naoyuki-iot/RRC_damian_2019/Pictures/soldered_parts_PCB.jpeg

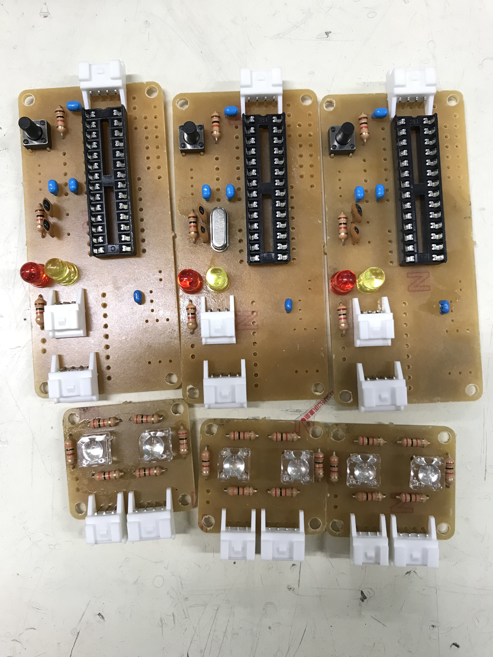
Pictures/soldered_parts_PCB.jpeg
