naoyuki-iot/RRC_damian_2019/Pictures/Head_Damian_Board.jpeg

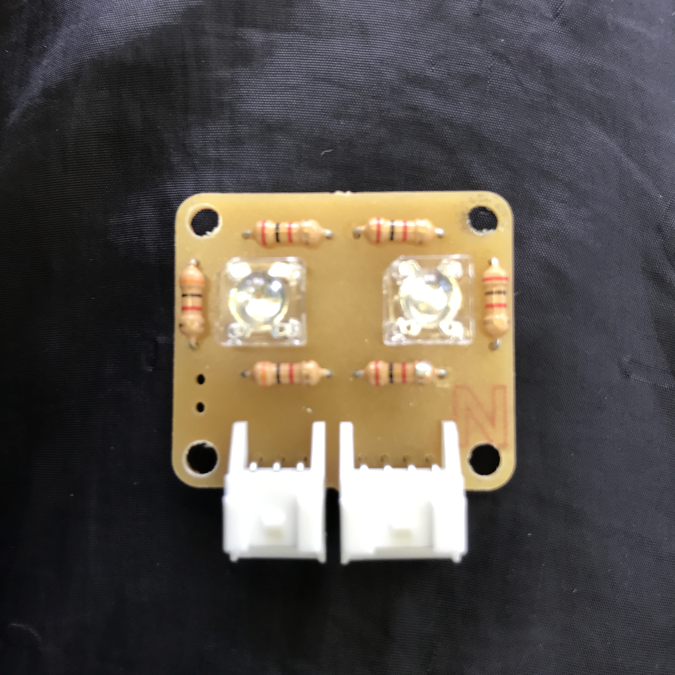
Pictures/Head_Damian_Board.jpeg
