naoyuki-iot/RRC_damian_2019/README.md

# RRC_damian_2019
- "Damian" is a rescue dummy as a rescuer on RRC.
