naoyuki-iot/RRC_damian_2019/Pictures/Body_Damian.png

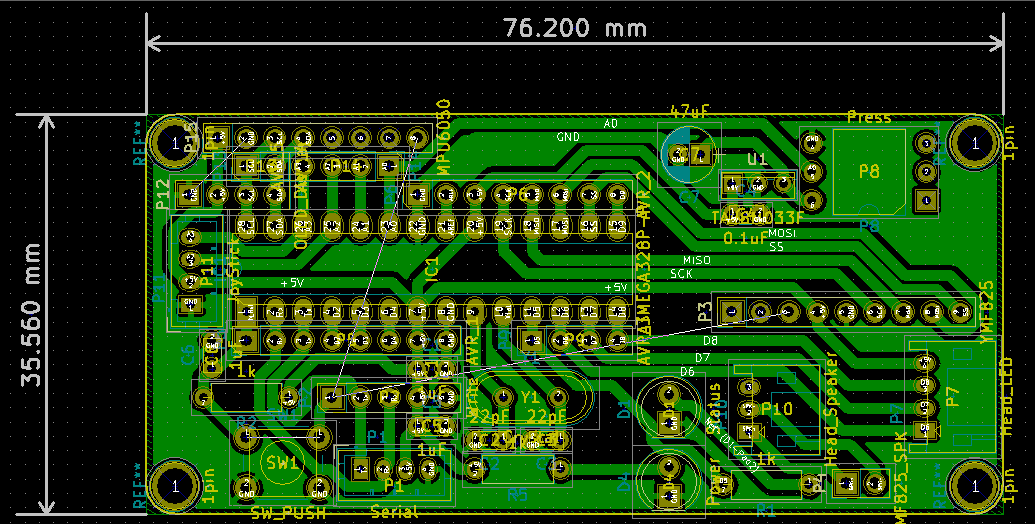
Pictures/Body_Damian.png
