naoyuki-iot/RRC_damian_2019/Pictures/Body_Damian_Board.jpeg

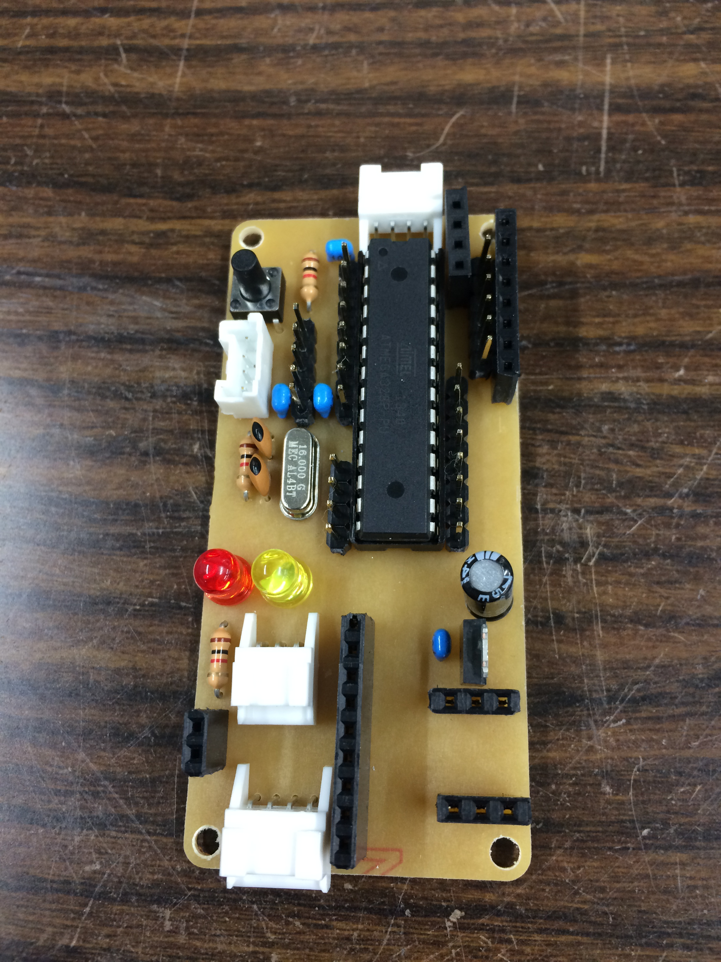
Pictures/Body_Damian_Board.jpeg
