naoyuki-iot/RRC_damian_2019/Pictures/Head_Damian.png

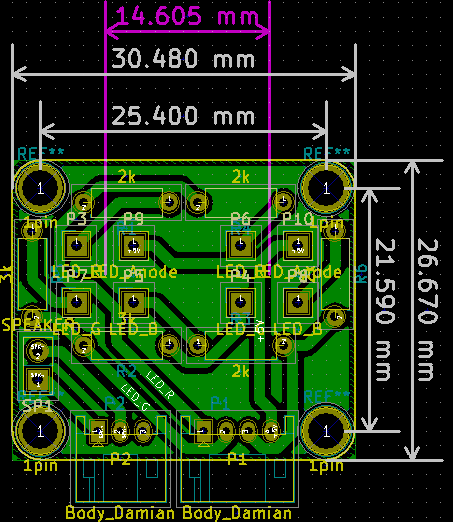
Pictures/Head_Damian.png
