naoyuki-iot/RRC_damian_2019/Pictures/raw_PCB.jpeg

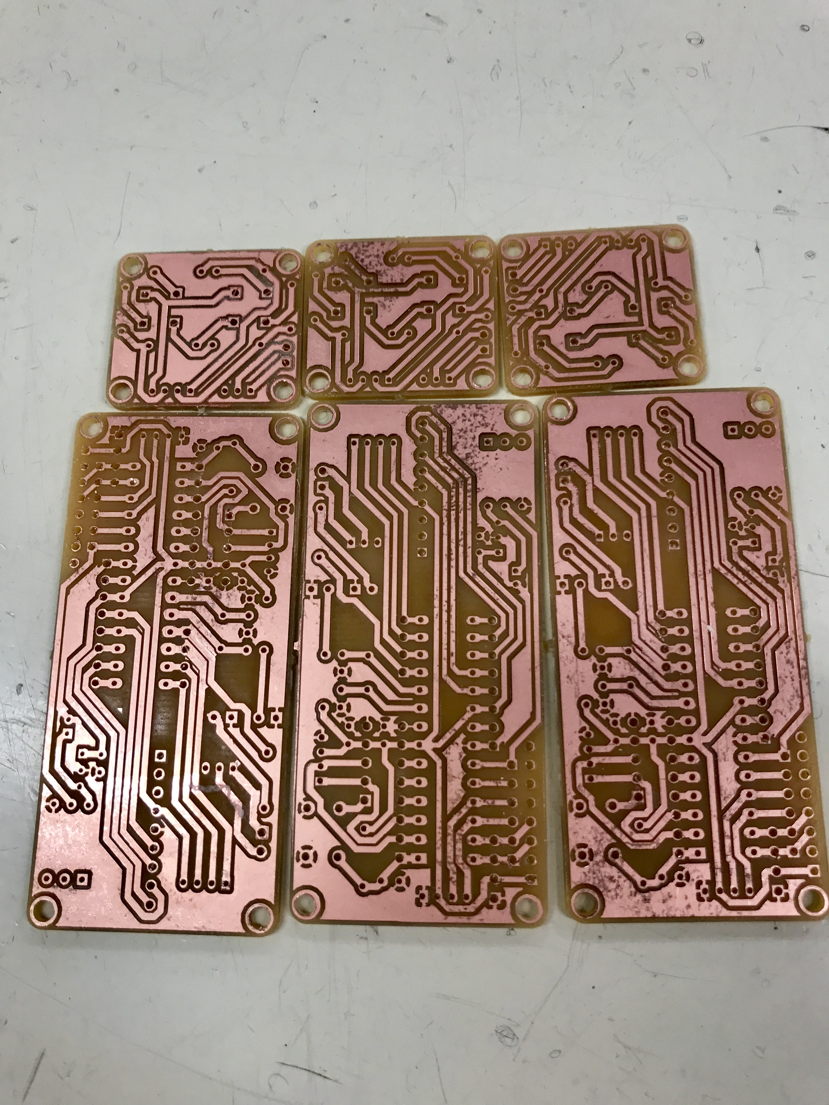
Pictures/raw_PCB.jpeg
