naoyuki-iot/RRC_damian_2019/Pictures/SerialCable(TTL232).jpg

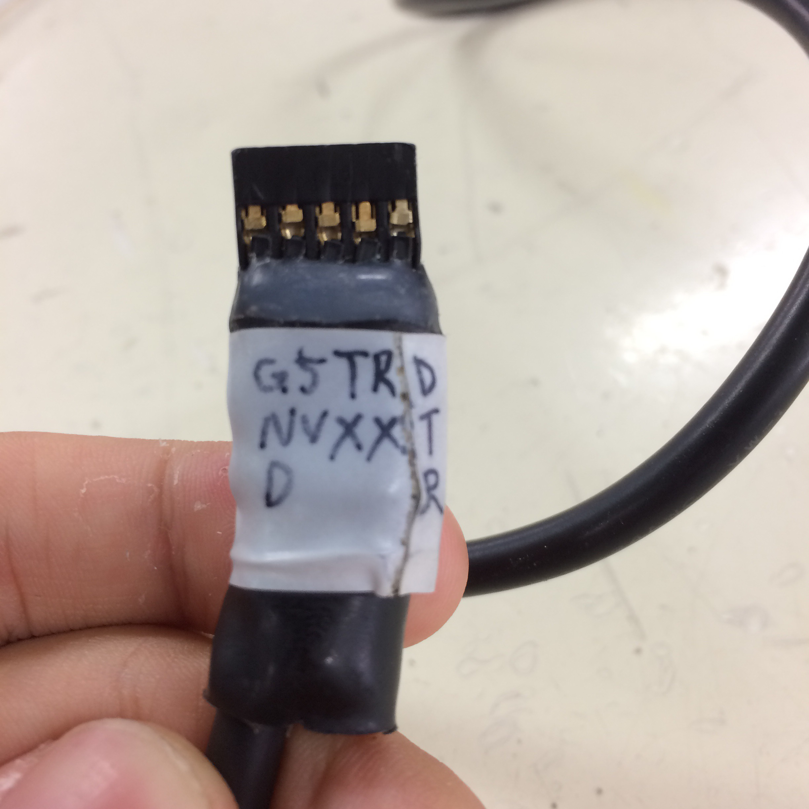
Pictures/SerialCable(TTL232).jpg
