naoyuki-iot/RRC_damian_2019/Circuits/Body_Damian_v2/Main-MPU.kicad_pcb

## KiCad design Circuits/Body_Damian_v2/Main-MPU.kicad_pcb (2020-06-12)

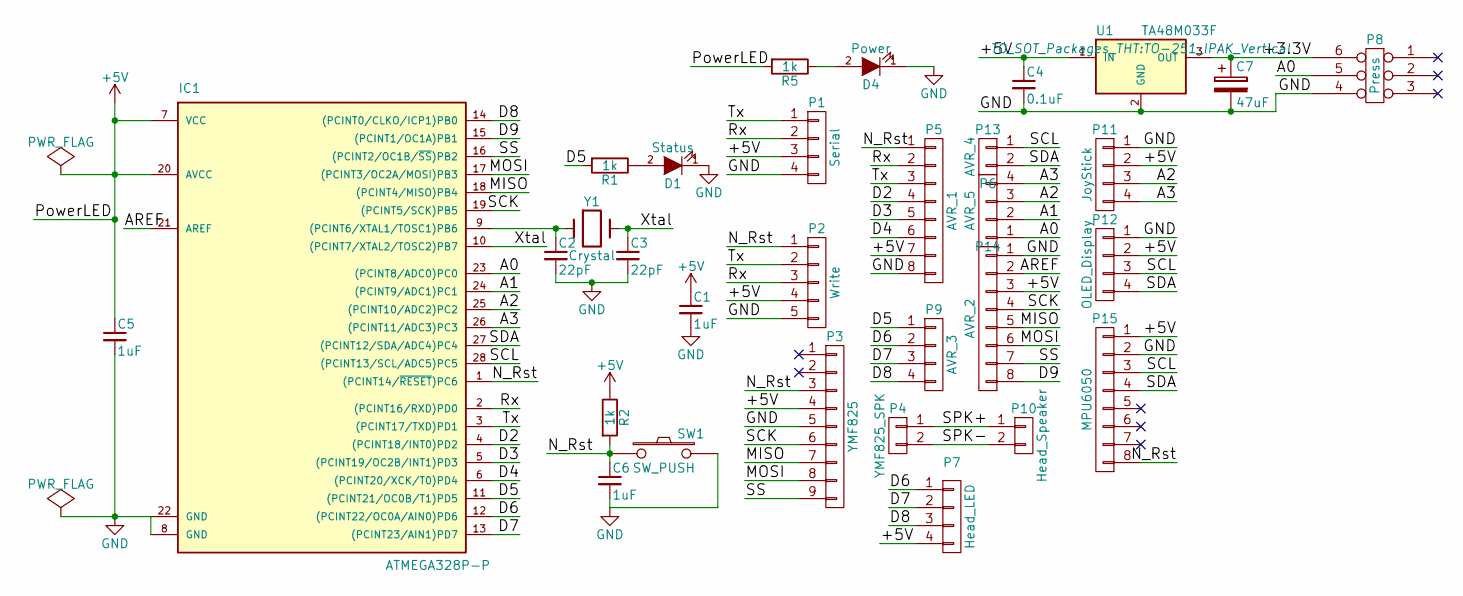
[picture p8: schematic Main-MPU.sch]

Parts:
C1, C5, C6: 1uF; C_Disc_D3.0mm_W1.6mm_P2.50mm
C2, C3: 22pF; C_Disc_D3.0mm_W1.6mm_P2.50mm
C4: 0.1uF; C_Disc_D3.0mm_W1.6mm_P2.50mm
C7: 47uF; CP_Radial_D5.0mm_P2.00mm
D1: Status; LED_D5.0mm
D4: Power; LED_D5.0mm
IC1: ATMEGA328P-P; DIP-28_W7.62mm_LongPads
P1: Serial; JST_PH_B4B-PH-K_04x2.00mm_Straight
P2: Write; Pin_Header_Straight_1x05_Pitch2.54mm
P3: YMF825; Socket_Strip_Straight_1x09_Pitch2.54mm
P4: YMF825_SPK; Socket_Strip_Straight_1x02_Pitch2.54mm
P5: AVR_1; Pin_Header_Straight_1x08_Pitch2.54mm
P6: AVR_2; Pin_Header_Straight_1x08_Pitch2.54mm
P7: Head_LED; JST_PH_S4B-PH-K_04x2.00mm_Angled
P8: Press; DIP-6_W10.16mm
P9: AVR_3; Pin_Header_Straight_1x04_Pitch2.54mm
P10: Head_Speaker; JST_PH_S3B-PH-K_03x2.00mm_Angled
P11: JoyStick; JST_PH_B4B-PH-K_04x2.00mm_Straight
P12: OLED_Display; Socket_Strip_Straight_1x04_Pitch2.54mm
P13: AVR_4; Pin_Header_Straight_1x02_Pitch2.54mm
P14: AVR_5; Pin_Header_Straight_1x04_Pitch2.54mm
P15: MPU6050; Socket_Strip_Straight_1x08_Pitch2.54mm
R1, R2, R5: 1k; R_Axial_DIN0207_L6.3mm_D2.5mm_P7.62mm_Horizontal
SW1: SW_PUSH; SW_PUSH_6mm_h7.3mm
U1: TA48M033F; TO-251_IPAK_Vertical
Y1: Crystal; Crystal_HC49-4H_Vertical

Connections:
+5V: C1.1, C4.1, C5.1, IC1.7 (VCC), IC1.20 (AVCC), P1.3, P2.4, P3.4, P5.7, P6.3, P7.4, P11.2, P12.2, P15.1, R2.1, R5.2, U1.1 (IN)
/+3.3V: C7.1, P8.6, U1.3 (OUT)
/A0: IC1.23 ((PCINT8/ADC0)PC0), P8.5, P14.1
/A1: IC1.24 ((PCINT9/ADC1)PC1), P14.2
/A2: IC1.25 ((PCINT10/ADC2)PC2), P11.3, P14.3
/A3: IC1.26 ((PCINT11/ADC3)PC3), P11.4, P14.4
/AREF: IC1.21 (AREF), P6.2
/D2: IC1.4 ((PCINT18/INT0)PD2), P5.4
/D3: IC1.5 ((PCINT19/OC2B/INT1)PD3), P5.5
/D4: IC1.6 ((PCINT20/XCK/T0)PD4), P5.6
/D5: IC1.11 ((PCINT21/OC0B/T1)PD5), P9.1, R1.2
/D6: IC1.12 ((PCINT22/OC0A/AIN0)PD6), P7.1, P9.2
/D7: IC1.13 ((PCINT23/AIN1)PD7), P7.2, P9.3
/D8: IC1.14 ((PCINT0/CLKO/ICP1)PB0), P7.3, P9.4
/D9: IC1.15 ((PCINT1/OC1A)PB1), P6.8
/MISO: IC1.18 ((PCINT4/MISO)PB4), P3.7, P6.5
/MOSI: IC1.17 ((PCINT3/OC2A/MOSI)PB3), P3.8, P6.6
/N_Rst: C6.1, IC1.1 ((PCINT14/~RESET~)PC6), P2.1, P3.3, P5.1, P15.8, R2.2, SW1.1
/Rx: IC1.2 ((PCINT16/RXD)PD0), P1.2, P2.3, P5.2
/SCK: IC1.19 ((PCINT5/SCK)PB5), P3.6, P6.4
/SCL: IC1.28 ((PCINT13/SCL/ADC5)PC5), P12.3, P13.1, P15.3
/SDA: IC1.27 ((PCINT12/SDA/ADC4)PC4), P12.4, P13.2, P15.4
/SPK+: P4.1, P10.1
/SPK-: P4.2, P10.2
/SS: IC1.16 ((PCINT2/OC1B/~SS~)PB2), P3.9, P6.7
/Tx: IC1.3 ((PCINT17/TXD)PD1), P1.1, P2.2, P5.3
/Xtal: C3.1, IC1.10 ((PCINT7/XTAL2/TOSC2)PB7), Y1.2
GND: C1.2, C2.2, C3.2, C4.2, C5.2, C6.2, C7.2, D1.1 (K), D4.1 (K), IC1.8 (GND), IC1.22 (GND), P1.4, P2.5, P3.5, P5.8, P6.1, P8.4, P11.1, P12.1, P15.2, SW1.2, U1.2 (GND)
unnamed: C2.1, IC1.9 ((PCINT6/XTAL1/TOSC1)PB6), Y1.1
unnamed: D1.2 (A), R1.1
unnamed: D4.2 (A), R5.1

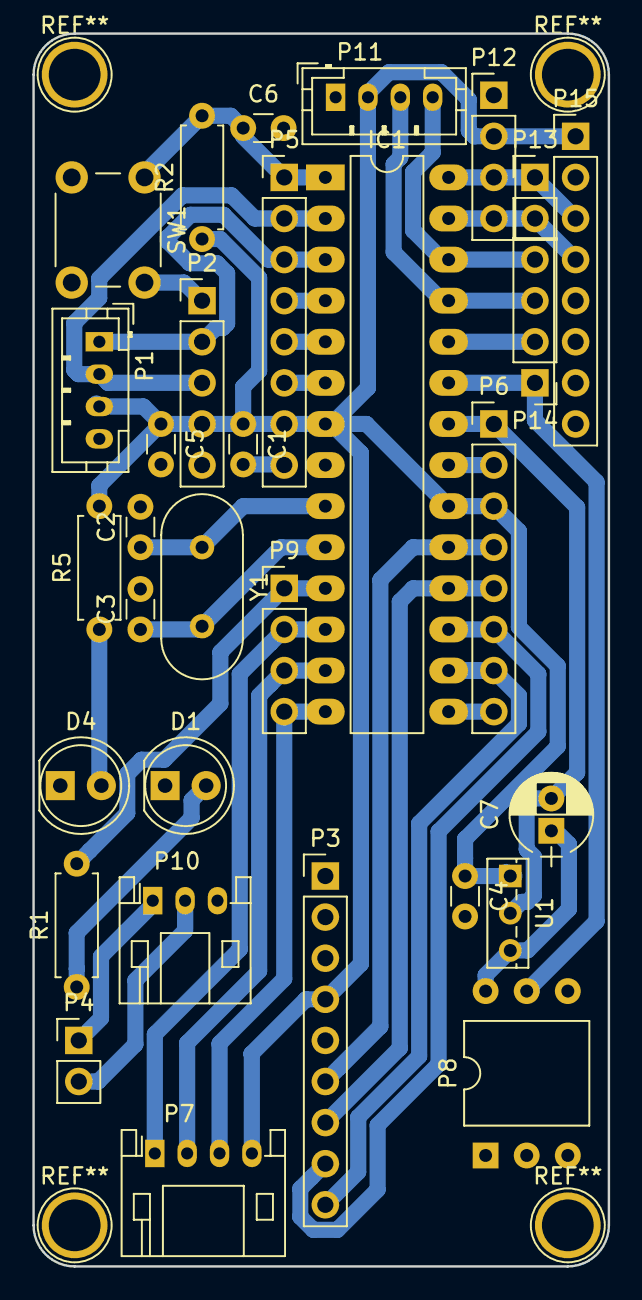
[picture p9: board Main-MPU.kicad_pcb from above]

Board: 2 copper layers, 35.6 x 76.2 mm, 31 parts (0 on the bottom side), 31 nets.
