naoyuki-iot/RRC_damian_2019/Circuits/PowerSupply_Damian/Damian_PowerSupply.kicad_pcb

## KiCad design Circuits/PowerSupply_Damian/Damian_PowerSupply.kicad_pcb (2020-03-20)

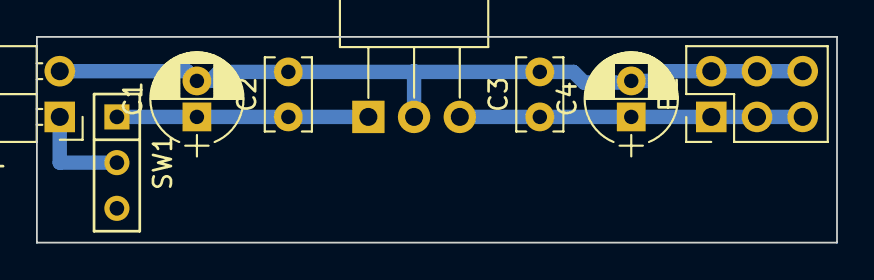
[picture p10: board Damian_PowerSupply.kicad_pcb from above]

Board: 2 copper layers, 44.4 x 11.4 mm, 8 parts (0 on the bottom side), 4 nets.

Parts:
BT1: Battery; Pin_Header_Angled_1x02_Pitch2.54mm
C1, C4: CP; CP_Radial_D5.0mm_P2.00mm
C2, C3: C; C_Rect_L4.0mm_W2.5mm_P2.50mm
P1: CONN_02X03; Pin_Header_Straight_2x03_Pitch2.54mm
SW1: SWITCH_INV; SW_Micro_SPST
U1: 7805; TO-126_Horizontal

Connections:
+5V: C3.1, C4.1, P1.1, P1.3, P1.5, U1.3
GND: BT1.2, C1.2, C2.2, C3.2, C4.2, P1.2, P1.4, P1.6, U1.2
unnamed: BT1.1, SW1.2
unnamed: C1.1, C2.1, SW1.1, U1.1
