naoyuki-iot/RRC_damian_2019/Circuits/Head_Damian_v2/Head_Damian.kicad_pcb

## KiCad design Circuits/Head_Damian_v2/Head_Damian.kicad_pcb (2020-03-20)

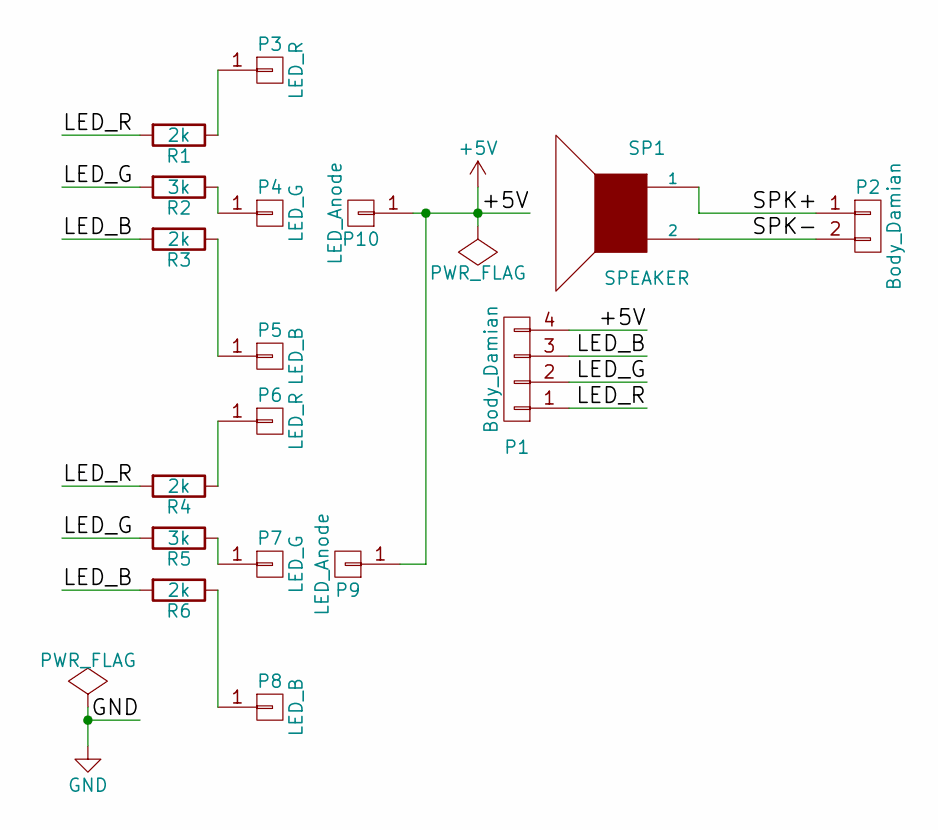
[picture p11: schematic Head_Damian.sch]

Parts:
P1: Body_Damian; JST_PH_S4B-PH-K_04x2.00mm_Angled
P2: Body_Damian; JST_PH_S3B-PH-K_03x2.00mm_Angled
P3, P6: LED_R; Socket_Strip_Straight_1x01_Pitch2.54mm
P4, P7: LED_G; Socket_Strip_Straight_1x01_Pitch2.54mm
P5, P8: LED_B; Socket_Strip_Straight_1x01_Pitch2.54mm
P9, P10: LED_Anode; Socket_Strip_Straight_1x01_Pitch2.54mm
R1, R3, R4, R6: 2k; R_Axial_DIN0207_L6.3mm_D2.5mm_P7.62mm_Horizontal
R2, R5: 3k; R_Axial_DIN0207_L6.3mm_D2.5mm_P7.62mm_Horizontal
SP1: SPEAKER; Socket_Strip_Straight_1x02_Pitch2.54mm

Connections:
+5V: P1.4, P9.1, P10.1
/LED_B: P1.3, R3.2, R6.2
/LED_G: P1.2, R2.2, R5.2
/LED_R: P1.1, R1.2, R4.2
/SPK+: P2.1, SP1.1
/SPK-: P2.2, SP1.2
unnamed: P3.1, R1.1
unnamed: P4.1, R2.1
unnamed: P5.1, R3.1
unnamed: P6.1, R4.1
unnamed: P7.1, R5.1
unnamed: P8.1, R6.1

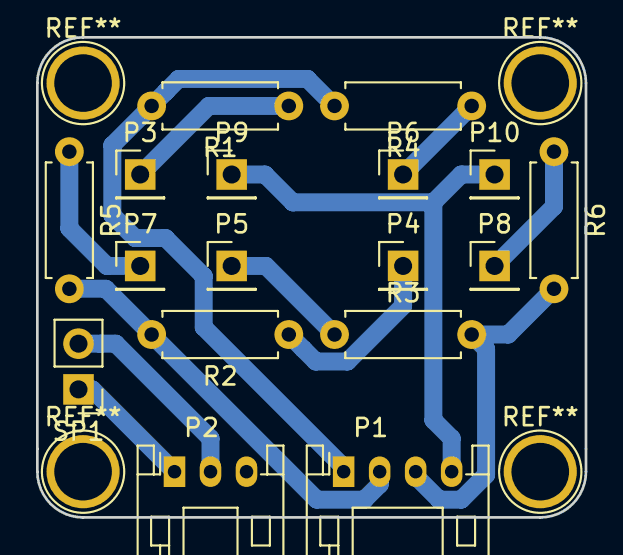
[picture p12: board Head_Damian.kicad_pcb from above]

Board: 2 copper layers, 30.5 x 26.7 mm, 17 parts (0 on the bottom side), 12 nets.
