naoyuki-iot/RRC_damian_2019/Develop/Damian_v0.35/character_data_ASCII_16x8.ino

//PROGMEM:フラッシュメモリに大きなデータを格納するための修飾子
/*
10進 16進 文字
32  0x20  SPC（空白文字）
33  0x21  !
34  0x22  "
35  0x23  #
36  0x24  $
37  0x25  %
38  0x26  &
39  0x27  '
40  0x28  (
41  0x29  )
42  0x2A  *
43  0x2B  +
44  0x2C  ,
45  0x2D  -
46  0x2E  .
47  0x2F  /
48  0x30  0
49  0x31  1
50  0x32  2
51  0x33  3
52  0x34  4
53  0x35  5
54  0x36  6
55  0x37  7
56  0x38  8
57  0x39  9
58  0x3A  :
59  0x3B  ;
60  0x3C  <
61  0x3D  =
62  0x3E  >
63  0x3F  ?
64  0x40  @
65  0x41  A
66  0x42  B
67  0x43  C
68  0x44  D
69  0x45  E
70  0x46  F
71  0x47  G
72  0x48  H
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
127 0x7F  DEL（削除）
 */
PROGMEM const byte ASCII_0x20_16x8[] = {
  B00000000, B00000000,
  B00000000, B00000000,
  B00000000, B00000000,
  B00000000, B00000000,
  B00000000, B00000000,
  B00000000, B00000000,
  B00000000, B00000000,
  B00000000, B00000000,
};

PROGMEM const byte ASCII_0x21_16x8[] = {
  B00000000, B00000000,
  B00000000, B00000000,
  B00010000, B00001000,
  B00111001, B11111100,
  B00010000, B00001000,
  B00000000, B00000000,
  B00000000, B00000000,
  B00000000, B00000000,
};

PROGMEM const byte ASCII_0x22_16x8[] = {
  B00000000, B00000000,
  B00000000, B00100110,
  B00000000, B00011110,
  B00000000, B00000000,
  B00000000, B00100110,
  B00000000, B00011110,
  B00000000, B00000000,
  B00000000, B00000000,
};

PROGMEM const byte ASCII_0x23_16x8[] = {
  B00000010, B00100000,
  B00011111, B11111100,
  B00000010, B00100000,
  B00000010, B00100000,
  B00000010, B00100000,
  B00011111, B11111100,
  B00000010, B00100000,
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
  B00000000, B00000000,
  B00000000, B00000000,
};

PROGMEM const byte ASCII_0x7D_16x8[] = {
  B00000000, B00000000,
  B01000000, B00000001,
  B00100000, B00000010,
  B00010000, B00000100,
  B00001111, B01111000,
  B00000000, B10000000,
  B00000000, B10000000,
  B00000000, B00000000,
};

PROGMEM const byte ASCII_0x7E_16x8[] = {
  B00000000, B00000000,
  B00000000, B00001000,
  B00000000, B00000100,
  B00000000, B00000100,
  B00000000, B00001000,
  B00000000, B00010000,
  B00000000, B00010000,
  B00000000, B00001000,
};

const byte *ASCII_16x8[] = { //externして使う
  ASCII_0x20_16x8, ASCII_0x21_16x8, ASCII_0x22_16x8, ASCII_0x23_16x8, ASCII_0x24_16x8, ASCII_0x25_16x8, ASCII_0x26_16x8, ASCII_0x27_16x8, ASCII_0x28_16x8, ASCII_0x29_16x8, ASCII_0x2A_16x8, ASCII_0x2B_16x8, ASCII_0x2C_16x8, ASCII_0x2D_16x8, ASCII_0x2E_16x8, ASCII_0x2F_16x8,
  ASCII_0x30_16x8, ASCII_0x31_16x8, ASCII_0x32_16x8, ASCII_0x33_16x8, ASCII_0x34_16x8, ASCII_0x35_16x8, ASCII_0x36_16x8, ASCII_0x37_16x8, ASCII_0x38_16x8, ASCII_0x39_16x8, ASCII_0x3A_16x8, ASCII_0x3B_16x8, ASCII_0x3C_16x8, ASCII_0x3D_16x8, ASCII_0x3E_16x8, ASCII_0x3F_16x8,
  ASCII_0x40_16x8, ASCII_0x41_16x8, ASCII_0x42_16x8, ASCII_0x43_16x8, ASCII_0x44_16x8, ASCII_0x45_16x8, ASCII_0x46_16x8, ASCII_0x47_16x8, ASCII_0x48_16x8, ASCII_0x49_16x8, ASCII_0x4A_16x8, ASCII_0x4B_16x8, ASCII_0x4C_16x8, ASCII_0x4D_16x8, ASCII_0x4E_16x8, ASCII_0x4F_16x8,
  ASCII_0x50_16x8, ASCII_0x51_16x8, ASCII_0x52_16x8, ASCII_0x53_16x8, ASCII_0x54_16x8, ASCII_0x55_16x8, ASCII_0x56_16x8, ASCII_0x57_16x8, ASCII_0x58_16x8, ASCII_0x59_16x8, ASCII_0x5A_16x8, ASCII_0x5B_16x8, ASCII_0x5C_16x8, ASCII_0x5D_16x8, ASCII_0x5E_16x8, ASCII_0x5F_16x8,
  ASCII_0x60_16x8, ASCII_0x61_16x8, ASCII_0x62_16x8, ASCII_0x63_16x8, ASCII_0x64_16x8, ASCII_0x65_16x8, ASCII_0x66_16x8, ASCII_0x67_16x8, ASCII_0x68_16x8, ASCII_0x69_16x8, ASCII_0x6A_16x8, ASCII_0x6B_16x8, ASCII_0x6C_16x8, ASCII_0x6D_16x8, ASCII_0x6E_16x8, ASCII_0x6F_16x8,

  ASCII_0x70_16x8, ASCII_0x71_16x8, ASCII_0x72_16x8, ASCII_0x73_16x8, ASCII_0x74_16x8, ASCII_0x75_16x8, ASCII_0x76_16x8, ASCII_0x77_16x8, ASCII_0x78_16x8, ASCII_0x79_16x8, ASCII_0x7A_16x8, ASCII_0x7B_16x8, ASCII_0x7C_16x8, ASCII_0x7D_16x8, ASCII_0x7E_16x8,
};
