naoyuki-iot/RRC_damian_2019/Develop/Damian_v0.35/YMF825_Func.ino

// only for Arduino UNO
void set_ss_pin(int val) {
    if(val ==HIGH) PORTB |= (4);
    else PORTB &= ~(4);
}

// only for Arduino UNO
void set_rst_pin(int val) {
    if(val ==HIGH) PORTB |= (2);
    else PORTB &= ~(2);
}

void if_write(char addr,unsigned char* data,char num){
  char i;
  char snd;
    set_ss_pin(LOW);
    SPI.transfer(addr);
    for(i=0;i<num;i++){
      SPI.transfer(data[i]);    
    }
    set_ss_pin(HIGH);  
}

void if_s_write(char addr,unsigned char data){
  if_write(addr,&data,1);
}

unsigned char if_s_read(char addr){
  
    unsigned char rcv;
    
    set_ss_pin(LOW);    
    SPI.transfer(0x80|addr);
    rcv = SPI.transfer(0x00);
    set_ss_pin(HIGH);  
    return rcv;  
}

void init_825(void) {
   set_rst_pin(LOW);
   delay(1);
   set_rst_pin(HIGH);
   if_s_write( 0x1D, OUTPUT_power );
   if_s_write( 0x02, 0x0E );
   delay(1);
   if_s_write( 0x00, 0x01 );//CLKEN
   if_s_write( 0x01, 0x00 ); //AKRST
   if_s_write( 0x1A, 0xA3 );
   delay(1);
   if_s_write( 0x1A, 0x00 );
   delay(30);
   if_s_write( 0x02, 0x04 );//AP1,AP3
   delay(1);
   if_s_write( 0x02, 0x00 );
   //add
   if_s_write( 0x19, 0xF0 );//MASTER VOL
   if_s_write( 0x1B, 0x3F );//interpolation
   if_s_write( 0x14, 0x00 );//interpolation
   if_s_write( 0x03, 0x01 );//Analog Gain
   
   if_s_write( 0x08, 0xF6 );
   delay(21);
   if_s_write( 0x08, 0x00 );
   if_s_write( 0x09, 0xF8 );
   if_s_write( 0x0A, 0x00 );
   
   if_s_write( 0x17, 0x40 );//MS_S
   if_s_write( 0x18, 0x00 );
}

void set_tone(void){
  unsigned char tone_data[35] ={//tone_data[35]は音色の情報
    0x81,//ヘッダ
    //T_ADR 0
    0x01,//BO (Basic Octave):オクターブの設定
    0x85,//LFO(低周波発振周波数)、FMアルゴリズムの設定
    
    //オペレータ1の設定
    0x00,//SR,XOF,KSR
    0x7F,//RR(解除レート),DR(減衰レート)
    0xF4,//AR(アタックレート),SL(持続レベル)
    0xBB,//TL(トータルレベル),KSL(キースケーリングレベル)
    0x00,//DAM(増幅変調深度),EAM(増幅変調有効化),DVB(ビブラートの深度)
    0x10,//MULTI(周波数倍率),DT(デチューン:音程を微妙にずらし音を重ねる)
    0x40,//WS(波形),FB(FMフィードバックレベル)

    //オペレータ2の設定
    0x00,//SR,XOF,KSR
    0xAF,//RR,DR
    0xA0,//AR,SL
    0x0E,//TL,KSL
    0x03,//DAM,EAM,DVB
    0x10,//MULTI,DT
    0x40,//WS,FB
    
    //オペレータ3の設定
    0x00,//SR,XOF,KSR
    0x2F,//RR,DR
    0xF3,//AR,SL
    0x9B,//TL,KSL
    0x00,//DAM,EAM,DVB
    0x20,//MULTI,DT
    0x41,//WS,FB

    //オペレータ4の設定
    0x00,//SR,XOF,KSR
    0xAF,//RR,DR
    0xA0,//AR,SL
    0x0E,//TL,KSL
    0x01,//DAM,EAM,DVB
    0x10,//MULTI,DT
    0x40,//WS,FB
    
    0x80,0x03,0x81,0x80,//データの終わり
  };
  
   if_s_write( 0x08, 0xF6 );
   delay(1);
   if_s_write( 0x08, 0x00 );
  
   if_write( 0x07, &tone_data[0], 35 );//write to FIFO
}

void set_ch(void){
   if_s_write( 0x0F, 0x30 );// keyon = 0
   if_s_write( 0x10, 0x71 );// chvol
   if_s_write( 0x11, 0x00 );// XVB
   if_s_write( 0x12, 0x08 );// FRAC
   if_s_write( 0x13, 0x00 );// FRAC  
}

void keyon(unsigned char fnumh, unsigned char fnuml){
   if_s_write( 0x0B, 0x00 );//voice num
   if_s_write( 0x0C, 0x54 );//vovol
   if_s_write( 0x0D, fnumh );//fnum
   if_s_write( 0x0E, fnuml );//fnum
   if_s_write( 0x0F, 0x40 );//keyon = 1  
}

void keyoff(void){
   if_s_write( 0x0F, 0x00 );//keyon = 0
}
