naoyuki-iot/RRC_damian_2019/(commit log)

2020-03-20 Add files via upload
    Arduino
2020-03-20 Add files via upload
    Using KiCAD
    [Damian_PowerSupply.kicad_pcb, Damian_PowerSupply.sch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]
